Tonylo-lab/pneumatic-gripper-fea/cad/README.md

# CAD

Portable STEP geometry is included so the design can be inspected without requiring the original SolidWorks environment.

## Files

- `baseline_gripper.STEP` — baseline gripper assembly geometry
- `original_block.STEP` — original baseline contact block
- `case_a1_corrected_block.STEP` — contact block with the 3° A1 wedge correction
- `original_jaw_plate.STEP` — original jaw plate used in the baseline / A1 design
- `final_a2_gripper.STEP` — final A2 gripper assembly geometry
- `final_a2_jaw_plate.STEP` — topology-informed final jaw plate

The STEP files provide neutral exchange geometry for CAD/CAE inspection across the baseline, A1 contact correction, and final A2 redesign.
