Tonylo-lab/pneumatic-gripper-fea/assets/baseline/mesh_convergenced.png

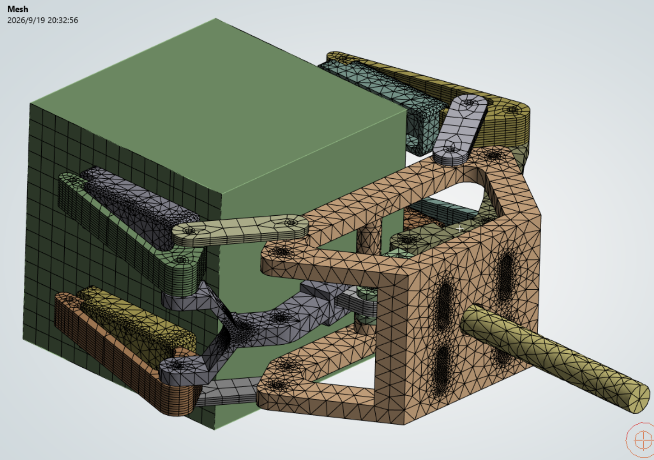
assets/baseline/mesh_convergenced.png
