Tonylo-lab/pneumatic-gripper-fea/cad/case_a1_corrected_block.STEP

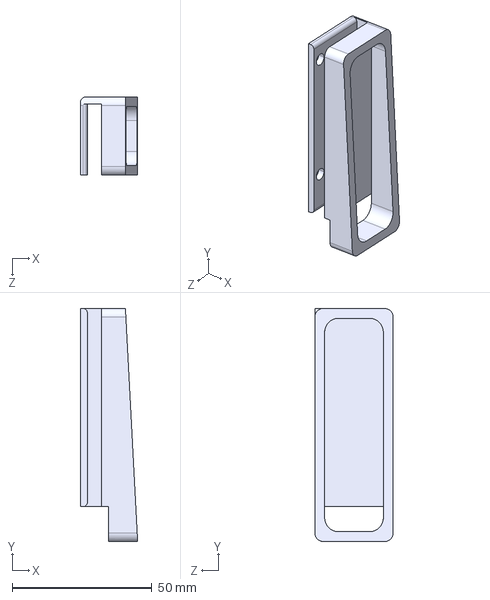
[picture p13: CAD file, 2026-09-20]
cad/case_a1_corrected_block.STEP
20.5 x 83.4 x 28.0 mm
