Tonylo-lab/pneumatic-gripper-fea/cad/original_block.STEP

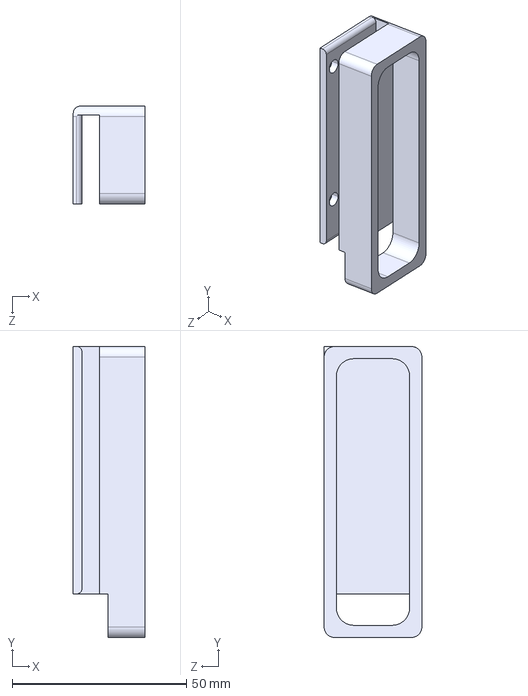
[picture p14: CAD file, 2026-09-20]
cad/original_block.STEP
20.5 x 83.4 x 28.0 mm
