Tonylo-lab/pneumatic-gripper-fea/cad/baseline_gripper.STEP

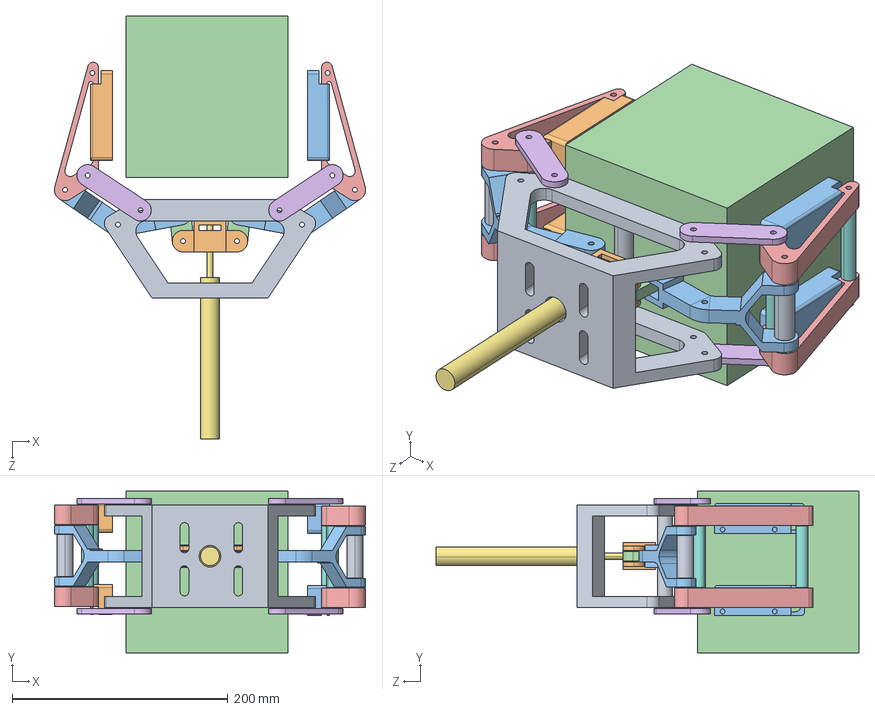
[picture p15: CAD file, 2026-09-19]
cad/baseline_gripper.STEP
288.7 x 150.0 x 392.3 mm
Gripper_Mounting_Frame-1
Actuator_Crosshead-1
Actuation_Link-1 x 2
Coupler_Link-1 x 2
Gripper_Jaw_Plate-1 x 4
Jaw_Guide_Link-1 x 4
Actuator_Push_Rod-1
Jaw_Plate_Spacer_Sleeve x 4
Actuation_Link_Spacer_Sleeve x 2
Jaw_Contact_Block_A-1 x 2
Jaw_Contact_Block_B-1 x 2
