Tonylo-lab/pneumatic-gripper-fea/cad/final_a2_jaw_plate.STEP

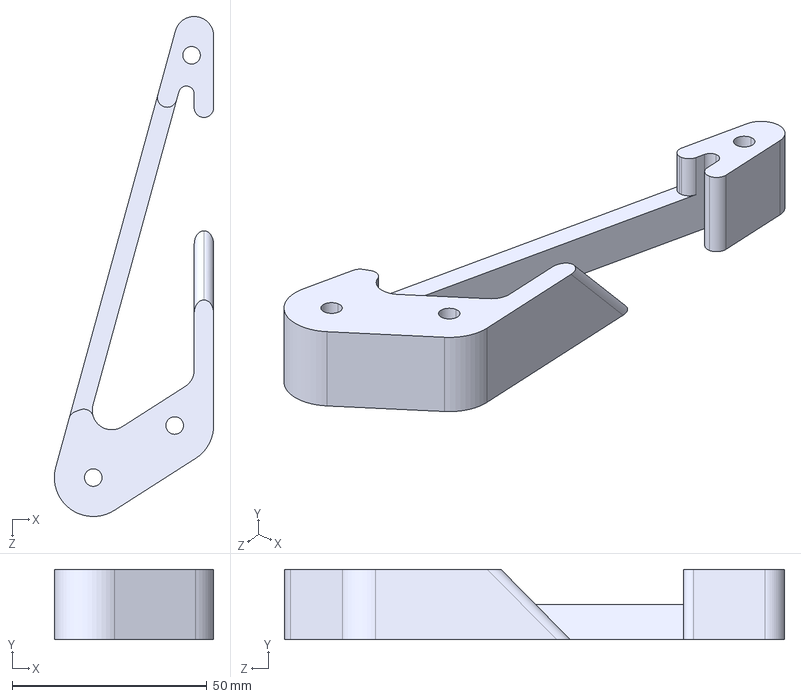
[picture p16: CAD file, 2026-09-19]
cad/final_a2_jaw_plate.STEP
40.9 x 18.0 x 128.4 mm
