Tonylo-lab/pneumatic-gripper-fea/cad/final_a2_gripper.STEP

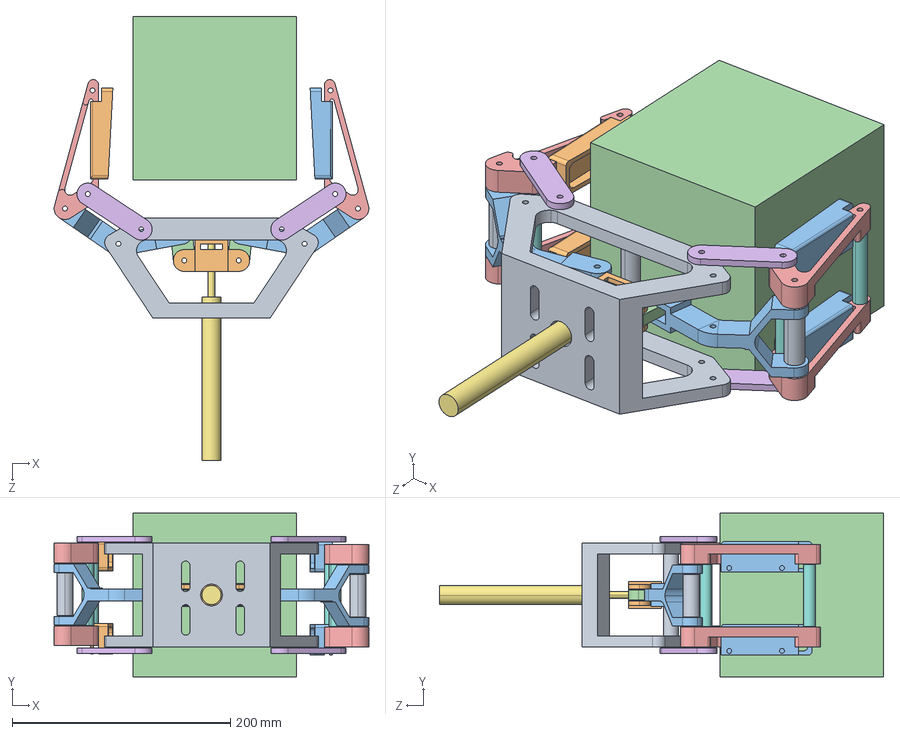
[picture p17: CAD file, 2026-09-19]
cad/final_a2_gripper.STEP
288.7 x 150.0 x 407.3 mm
Gripper_Mounting_Frame_默认
Actuator_Crosshead_默认
Actuation_Link_默认 x 2
Coupler_Link_默认 x 2
Gripper_Jaw_Plate_默认 x 4
Jaw_Guide_Link_默认 x 4
Actuator_Push_Rod_默认
Jaw_Plate_Spacer_Sleeve x 4
Actuation_Link_Spacer_Sleeve x 2
Jaw_Contact_Block_A x 2
Jaw_Contact_Block_B x 2
cube_默认
