Tonylo-lab/pneumatic-gripper-fea/cad/original_jaw_plate.STEP

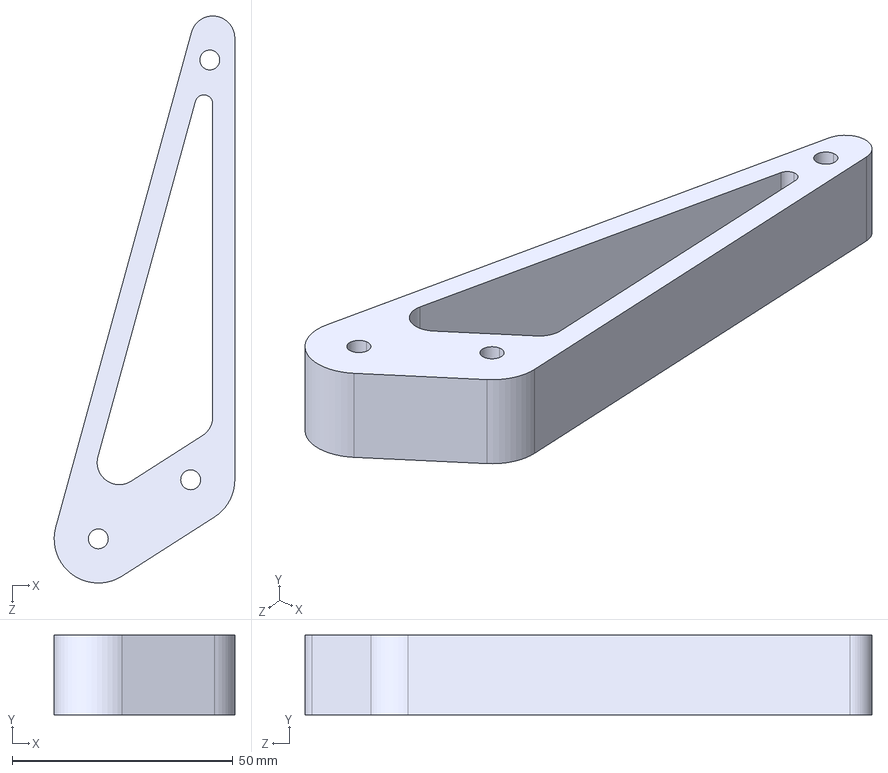
[picture p18: CAD file, 2026-09-19]
cad/original_jaw_plate.STEP
40.9 x 18.0 x 128.4 mm
