Tonylo-lab/pneumatic-gripper-fea/results/README.md

# Results

This directory contains the numerical outputs used in the project documentation.

## Files

- `summary.csv` — consolidated Baseline, Case A1, and Final A2 metrics.
- `gripper_fea_results.xlsx` — full design-study workbook containing the load study, mesh-convergence study, case results, and comparison tables.

## Result conventions

- **Baseline** is the production reference model using the selected M2 mesh.
- **Case A1** applies the 3° contact-face correction.
- **Final A2** is the topology-informed jaw-plate redesign validated in the full nonlinear gripper assembly.
- Reaction force is reported for the prescribed actuator displacement and should not be interpreted as a directly measured pneumatic gripping-force rating.
