Tonylo-lab/pneumatic-gripper-fea/results/gripper_fea_results.xlsx

Sheet: Overview
Pneumatic Gripper FEA Design Study
Study Structure
Stage | Parent | Design Change | Evaluation
Baseline | — | Reference model | Production nonlinear FEA
Case A1 | Baseline | Jaw Contact Block face correction (+3°) | Contact / load-transfer validation
Case A2 | Case A1 | Topology-informed Jaw Plate lightweighting | Topology study + CAD redesign
Final Validation | Case A2 | Full gripper with redesigned Jaw Plate | Nonlinear full-assembly validation
Common FEA Setup
Parameter | Value | Unit
Actuator displacement | -28.8 | mm
PLA Young's modulus | 2000 | MPa
Poisson's ratio | 0.35 | —
Cube | Rigid | —
Block–Cube contact | Frictionless | —
Large Deflection | On | —
Baseline production mesh | M2 | —

Sheet: Load Study
Gripping Load Study
Evaluation range | -20 to -28.8 mm
Run ID | Rod Retraction (mm) | LF Contact | LR Contact | RF Contact | RR Contact | Reaction Force (N) | Max Eq. Stress (MPa) | Max Principal Stress (MPa) | Max Deformation (mm) | Max Contact Pressure (MPa) | Max Penetration (mm) | Critical Stress Location
GLS-01 | -20.000 | Sliding | Sliding | Near Open | Near Open | 1.5402e-09 | 0.00035053 | 0.00025821 | 23.427 | 6.3308e-06 | 1.1007e-08 | none
GLS-02 | -20.500 | Sliding | Sliding | Near Open | Near Open | 6.8226e-08 | 0.00035951 | 0.00026587 | 24.026 | 8.9785e-06 | 1.561e-08 | none
GLS-03 | -21.000 | Sliding | Sliding | Near Open | Near Open | 4.9601e-08 | 0.00036859 | 0.00027361 | 24.625 | 2.9742e-05 | 5.1711e-08 | none
GLS-04 | -21.500 | Sliding | Sliding | Near Open | Near Open | 3.1441e-08 | 0.000 | 0.000 | 25.227 | 0.000 | 0.000 | none
GLS-05 | -22.000 | Sliding | Sliding | Near Open | Near Open | 9.8572e-09 | 0.000 | 0.000 | 25.830 | 0.000 | 0.000 | none
GLS-06 | -22.500 | Sliding | Sliding | Sliding | Sliding | 14.964 | 3.373 | 4.165 | 26.415 | 1.341 | 0.002 | Actuation Link – outer edges of the upper fork branches
GLS-07 | -23.000 | Sliding | Sliding | Sliding | Sliding | 32.537 | 7.281 | 9.020 | 26.998 | 2.903 | 0.005 | Actuation Link – outer edges of the upper fork branches
GLS-08 | -23.500 | Sliding | Sliding | Sliding | Sliding | 50.076 | 11.125 | 13.829 | 27.582 | 4.446 | 0.008 | Actuation Link – outer edges of the upper fork branches
GLS-09 | -24.000 | Sliding | Sliding | Sliding | Sliding | 67.582 | 14.906 | 18.592 | 28.167 | 5.972 | 0.010 | Actuation Link – outer edges of the upper fork branches
GLS-10 | -24.500 | Sliding | Sliding | Sliding | Sliding | 85.054 | 18.624 | 23.310 | 28.753 | 7.481 | 0.013 | Actuation Link – outer edges of the upper fork branches
GLS-11 | -25.000 | Sliding | Sliding | Sliding | Sliding | 102.490 | 22.280 | 27.983 | 29.341 | 8.974 | 0.016 | Actuation Link – outer edges of the upper fork branches
GLS-12 | -26.000 | Sliding | Sliding | Sliding | Sliding | 137.250 | 29.406 | 37.196 | 30.520 | 11.911 | 0.021 | Actuation Link – outer edges of the upper fork branches
GLS-13 | -27.000 | Sliding | Sliding | Sliding | Sliding | 171.870 | 36.285 | 46.233 | 31.704 | 14.780 | 0.026 | Actuation Link – outer edges of the upper fork branches
GLS-14 | -28.000 | Sliding | Sliding | Sliding | Sliding | 206.320 | 42.920 | 55.095 | 32.894 | 17.591 | 0.031 | Actuation Link – outer edges of the upper fork branches
GLS-15 | -28.500 | Sliding | Sliding | Sliding | Sliding | 223.480 | 46.146 | 59.463 | 33.490 | 18.974 | 0.033 | Actuation Link – outer edges of the upper fork branches
GLS-16 | -28.800 | Sliding | Sliding | Sliding | Sliding | 257.730 | 48.026 | 62.051 | 33.849 | 19.825 | 0.035 | Actuation Link – outer edges of the upper fork branches

Sheet: Mesh Convergence
Baseline Mesh Convergence – -28.8 mm
Mesh ID | Overall Size (mm) | Slots/Joints (mm) | Y-root (mm) | Critical Region (mm) | Nodes | Elements | Reaction Force (N) | Δ Force | Max Eq. Stress (MPa) | Δ Eq. Stress | Max Principal Stress (MPa) | Δ Principal | Max Contact Pressure (MPa) | Use
M0 | 10.000 | 2.500 | 3.000 | 2.500 | 115014 | 55882 | 257.220 |  | 47.865 |  | 61.712 |  | 19.812
M1 | 10.000 | 2.000 | 2.250 | 2.000 | 128372 | 62989 | 257.060 | 0.06% | 48.659 | 1.63% | 62.150 | 0.70% | 19.826
M2 | 10.000 | 1.500 | 1.700 | 1.500 | 168478 | 84428 | 256.670 | 0.15% | 48.007 | 1.36% | 57.060 | 8.92% | 19.779 | Production
M3 | 10.000 | 1.250 | 1.300 | 1.000 | 219611 | 113578 | 256.280 | 0.15% | 49.724 | 3.45% | 58.151 | 1.88% | 19.767

Sheet: Baseline
Baseline – Production Reference
Global Results (M2)
Metric | Value | Unit
Actuator Reaction Force | 256.670 | N
Max Equivalent Stress | 48.007 | MPa
Max Principal Stress | 57.060 | MPa
Max Contact Pressure | 19.779 | MPa
Nodes | 168478 | count
Elements | 84428 | count
Component Reference
Component | Mass (g / part) | Max Eq. Stress (MPa)
Jaw Plate | 40.100 | 8.937
Actuation Link | 41.500 | 36.710
Mounting Frame | 367.500 | 37.115

Sheet: Case A1
Case A1 – Contact Face Correction
Design / Solver Data
Parameter | Value | Unit
Parent model | Baseline | —
Baseline face misalignment | 5.300 | deg
CAD wedge correction | 3.000 | deg
Evaluation displacement | -28.800 | mm
Block–Cube contact | Frictionless | —
Stabilization damping | 0.100 | —
Initial / Min / Max substeps | 100 / 20 / 2000 | —
Max iterations / substep | 50 | —
Converged | Yes | —
Results
Metric | Baseline | Case A1 | Change | Unit
Actuator Reaction Force | 256.670 | 48.561 | -81.08% | N
Max Contact Pressure | 19.779 | 1.1391 | -94.24% | MPa
Jaw Plate Max Eq. Stress | 8.650 | 7.7262 | -10.68% | MPa
Jaw Contact Block Max Eq. Stress | 48.007 | 16.782 | -65.04% | MPa
Global Max Eq. Stress | 48.007 | 16.782 | -65.04% | MPa
Global Max Principal Stress | 57.060 | 27.354 | -52.06% | MPa
Total Contact Area | 32.3784 | 122.72 | 279.02% | mm²
Jaw Plate stress concentration | Localized point hotspot | Reduced point concentration

Sheet: Case A2
Case A2 – Topology-Informed Jaw Plate Redesign
Topology Optimization Setup
Parameter | Value | Unit
Parent design | Case A1 | —
Design region | Jaw Plate | —
Objective | Minimize compliance | —
Mass constraint | 70 | % retained
Optimization method | Mixable Density | —
Final CAD method | Topology-informed redesign | —
Jaw Plate Redesign
Metric | Case A1 | Final A2 | Change | Unit
Jaw Plate Mass / part | 40.100 | 31.198 | 22.20% | g
Jaw Plate Max Eq. Stress | 7.726 | 8.911 | 15.33% | MPa
Full Assembly Validation
Metric | Case A1 | Final A2 | Change | Unit
Actuator Reaction Force | 48.561 | 49.848 | 2.65% | N
Max Contact Pressure | 1.1391 | 0.579 | -49.16% | MPa
Total Contact Area | 122.72 | 287.179 | 134.01% | mm²
Global Max Eq. Stress | 16.782 | 11.485 | -31.56% | MPa
Global Max Principal Stress | 27.354 | 14.537 | -46.86% | MPa
Jaw Plate Max Eq. Stress | 7.7262 | 8.911 | 15.33% | MPa

Sheet: Final Validation
Final Validation – A2 Full Gripper
A1 vs Final A2
Metric | Case A1 | Final A2 | Change | Unit
Actuator Reaction Force | 48.561 | 49.848 | 2.65% | N
Max Contact Pressure | 1.1391 | 0.57908 | -49.16% | MPa
Total Contact Area | 122.72 | 287.179 | 134.01% | mm²
Global Max Eq. Stress | 16.782 | 11.485 | -31.56% | MPa
Global Max Principal Stress | 27.354 | 14.537 | -46.86% | MPa
Jaw Plate Max Eq. Stress | 7.7262 | 8.9109 | 15.33% | MPa
Jaw Plate Mass / part | 40.100 | 31.198 | 22.20% | g

Sheet: Comparison
Baseline vs Design Evolution
Metric | Unit | Baseline | Case A1 | Final A2
Actuator Reaction Force | N | 256.67 | 48.561 | 49.848
Max Contact Pressure | MPa | 19.779 | 1.1391 | 0.57908
Total Contact Area | mm² | 32.3784 | 122.72 | 287.179
Global Max Eq. Stress | MPa | 48.007 | 16.782 | 11.485
Global Max Principal Stress | MPa | 57.06 | 27.354 | 14.537
Jaw Plate Max Eq. Stress | MPa | 8.937 | 7.7262 | 8.9109
Jaw Plate Mass / part | g | 40.1 | 40.1 | 31.198
