Tonylo-lab/pneumatic-gripper-fea/RELEASE_NOTES.md

# Release v1.0

## Pneumatic Gripper FEA Design Study

This release contains the complete ANSYS Workbench archive for the **Final A2 nonlinear gripper validation**.

### Release asset

- `pneumatic_gripper_case_A2_final.wbpz`

### Project progression

Baseline → Case A1 contact-interface correction → topology-informed jaw-plate redesign → Final A2 full-assembly validation

### Repository contents

The repository includes:

- methodology and design rationale
- mesh-convergence study
- Baseline, Case A1, topology, and Final A2 result figures
- numerical result workbook and summary table
- baseline and final CAD exchange geometry in STEP format

The `.wbpz` archive is distributed as a release asset to keep the Git history lightweight.

### Software

- ANSYS Workbench / Mechanical 2026 R1
- ANSYS Discovery
- SolidWorks
