Tonylo-lab/pneumatic-gripper-fea/(commit log)

2026-09-19 Initialize pneumatic gripper FEA project README
2026-09-19 Add consolidated FEA result summary
    [summary.csv]
2026-09-19 Add CAD artifact notes
2026-09-19 Add ignore rules for ANSYS and CAD temporary data
2026-09-19 Organize figure assets into analysis-stage folders
2026-09-19 Add jaw plate before-and-after CAD comparison
2026-09-19 Add CAD exchange geometry
    [baseline_gripper.STEP, final_a2_gripper.STEP, final_a2_jaw_plate.STEP, original_jaw_plate.STEP]
2026-09-19 Document CAD exchange files
2026-09-19 Reference CAD exchange geometry in project README
2026-09-19 Clean cad/README.md project documentation
2026-09-20 Document Case A1 contact-block geometry correction
    [case_a1_corrected_block.STEP]
